chris7topher/SmartPhilips2200/(threads)

Thread 1 (2020-10-22):

Kabel Schneiden

M4D1NG3R, 2020-10-22:
Also erstmal echt cools Projekt,

ich habe mir gestern auch eine Philips EP2220/10 bestellt. Ich Wechsel von einer Smarter Coffee nun zu einem Vollautomaten, da mir der Kaffee auf der Smarter einfach nicht richtig schmeckt. Leider dauert es noch ein paar Tage bis diese geliefert wird.

Du hast in deinem 1. Video gesagt, dass du Kontakte an die Kabel gelötet hast. Ist das Kabel fest am Display verbaut oder sind dort Kontakte, sodass man evtl. durch Adapter o.Ä. auch ohne die original Kabel zu beschädigen die zusätzlichen Kabel anklemmen kann?

Und könntest du evtl. mal ein Bild in einer etwas besseren Auflösung als in deinem Video von der Schnittstelle am Display machen, das  würde mir zusätzlich wirklich helfen.

Schonmal Danke für deine Antwort!

LG

chris7topher, 2020-10-23:
Hallo,

das Kabel ist am Display angesteckt. Leider habe ich erst zu spät erfahren, dass es sich um einen Picoflex Stecker von Molex handelt. Schau am besten mal ins iobroker Forum, da habe ich mal ein paar Bilder eingestellt, wie ich das mittels Steckverbindungen gelöst habe:
[https://forum.iobroker.net/topic/30870/philips-kaffeevollautomat-ep2220-10-mittels-iobroker-steuern/21](forum.iobroker)

Am coolsten wäre es natürlich das einfach mit einem Picoflex Stecker als Zwischenmodul zu bauen.

M4D1NG3R, 2020-10-23:
Vielen Dank für die schnelle Antwort. Wieviele Pole hat denn das Picoflex Kabel?
Dann würde ich mir gleich eine Verlängerung bestellen :)

chris7topher, 2020-10-23:
Das ist ein 8 poliger Stecker. Das hier müsste der Typ vom Kabel zur Maschine hin sein: 90327-0308
Dazu bräuchtest du halt noch das männliche Gegenstück, das gibt es aber meines Wissens nach nur für Platinen zum auflöten. Beispielsweise das hier müsste laut Datenblatt passen: 90325-7008

Closed 2020-11-08.

Thread 2 (2021-09-29):

Verkabelung vereinfachen

student-maker, 2021-09-29:
Das Projekt ist klasse, aber die Verkabelung könnte denke ich noch etwas vereinfacht werden.
In https://github.com/chris7topher/SmartPhilips2200/issues/1#issuecomment-715045243 wurden ja bereits die Kabel und Stecker/Buchsen genannt.

Meinst du, es bestünde Interesse an einer Platine, auf der ein ESP8266 samt Spannungsregler und den korrekten Buchsen sitzt?

janniklas1998, 2022-01-07:
> Das Projekt ist klasse, aber die Verkabelung könnte denke ich noch etwas vereinfacht werden. In [#1 (comment)](https://github.com/chris7topher/SmartPhilips2200/issues/1#issuecomment-715045243) wurden ja bereits die Kabel und Stecker/Buchsen genannt.
>
> Meinst du, es bestünde Interesse an einer Platine, auf der ein ESP8266 samt Spannungsregler und den korrekten Buchsen sitzt?

Moin, wäre es möglich dass du dich per janniklas@muell.monster mal mit mir in Verbindung setzt? Hätte Interesse an so einer Platine

calipposcout, 2022-08-11:
Ich hätte tatsächlich Interesse daran. Die Kabel sind beim 2231/40 (LatteGo) wahrscheinlich gleich?

walthowd, 2022-08-11:
Ich wäre auch interessiert, habe aber die 3200-Serie und plane, diese in Zukunft zu erkunden.

Bobacatt, 2022-12-22:
Can someone pls sende an pinout for the D1? Mine isnt working Like it should.

Thread 3 (2021-11-21):

Confirming your connector had 5v power on both ends

poldim, 2021-11-21:
I found when doing some checking on my similar 3200 machine it has 5v on both pins 1 & 2 and 8 & 7.  Do you remember if this was the same for you?

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

veonua, 2022-09-08:
true

Thread 4 (2022-09-05):

Initialization is not complete

veonua, 2022-09-05:
When I send the power on command, it seems the chip doesn't send all the initialization commands needed.

The Hot Water test on my LatteGo 3200 ended up with a tray full of cold water. It doesn't even go through the regular pipe but dumps directly into the tray.

The coffee test ended up with cold coffee.

micki88, 2022-11-11:
I have the same machine (LatteGo 3200) and expiriencingsome strange behavior.
I have managed to map all the commands from the display (they are different to the 2200 model). But when I connect the esp to the machine and say press espresso, after some seconds it starts on its own and then just stops the process.
Maybe errors in the forward of the serail.read to serial.write?
I am new to arduino...

veonua, 2022-11-11:
@micki88 most likely you mapped commands wrong. do you have your code anywhere on GitHub

micki88, 2022-11-11:
@veonua Hi https://github.com/micki88/Philips-ep3200-testing This is just Christophers code that I modified fo ep 3200.

veonua, 2022-11-11:
my start commands are

  byte cmd1[] = {0xd5, 0x55, 0x0a, 0x01, 0x03, 0x00, 0x0d, 0x00, 0x00, 0x00, 0x1d, 0x36};
  byte cmd2[] = {0xd5, 0x55, 0x01, 0x01, 0x03, 0x00, 0x0d, 0x00, 0x00, 0x00, 0x36, 0x03};

I needed both to init successfully

micki88, 2022-11-11:
Thx. My problem the start/stopbutton/command. It is beeing randomly activated. So when I press something like coffee and wait, it just starts on his own. Or if I start making coffee the machine randomly stops if it has been stoped on the button. And I hear the beep sound, as you would press the start/stop button.
I dont understand how It is beeing activated on its own...

veonua, 2022-11-11:
probably you need to check your wires, the start/stop button command is just one bit. it might be a noise

micki88, 2022-11-13:
Thx veonua. I checked all wires again.  Still have same issue. Could the noise be coming from the unused softserial TX pin?

micki88, 2022-11-14:
[Solved]
Just to inform, I have solved the issue  by swapping the serial and software serial communication. It now works. Thx again for help.

sendorm, 2022-11-30:
Hello @micki88 so your codes works for ep3200 series right? Do all the settings work? The coffee types etc? Thanks

veonua, 2022-11-30:
it's just an emulation of a button press by button number.
I got a hidden “americano” discovered on my 2200 just by using the last known index +1 code

micki88, 2022-11-30:
Yup all works. Would be cool to find out the code for "steam" on the latteGo machines like mine. So we could make hot milk without the need to stop the capuccino or latteMachiato program

sendorm, 2022-11-30:
Do you have pictures of your setup and can you provide items list? People seem to be having issues with what to use. Which pin to connect etc? Maybe asking too much here :) Most of my experience is with esphome devices. Asked at their discord too if this can be implemented or not. Having this features on homeassistant will be great.

walthowd, 2022-11-30:
I'm a 3200 machine user as well, and would be happy to collaborate somewhere

veonua, 2022-12-01:
@walthowd just create a fork or a new project

flashmandv, 2024-01-01:
Guys, does anyone know what could be the reason for the display not working when powered on from the ESP?
My Phillips is EP3246. Commands work fine but I can't power on the display. If I power on the machine from its display button, then the display is updated OK when I send any commands from the ESP.

I checked the transistor and it works fine. It cuts the ground to the display for 300ms (tried different values). I also tried to cut the display GND manually or before/after sending the power on command. Nothing works. Please help me power on the display from the ESP.
Thanks

micki88, 2024-01-01:
@flashmandv probably wrong command or you maybe need two commands. Try command from my fork for 3200 series.

flashmandv, 2024-01-01:
@micki88 the commands from your repo should be fine as the machine turns on just fine. It is just the display that refuses to turn on :/ Maybe for my machine the cutout to ground for 300ms is not working..but it is strange as this works for the other machines from 3200 series.

micki88, 2024-01-01:
@flashmandv Ok, just to be sure, you did cut the other cables? I think I remember having two cables to ground on the display...

micki88, 2024-01-01:
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

Can you try this power on commands

flashmandv, 2024-01-01:
> @flashmandv Ok, just to be sure, you did cut the other cables? I think I remember having two cables to ground on the display...

Actually I haven't cut all the wires to the display. I only cut the Tx and the GND (that is next to the 5V).
Do I need to cut the other unused cables? The 3th cable (that is again GND) needs to be cut completely? or wired to the transistor so he cuts it momentarily?

Thanks for the new commands. I will try them today

flashmandv, 2024-01-01:
Thank you @micki88 It worked when I cut the 3th ground pin and connected it to the transistor emitter.
Now it remained to clear some strange bugs (setting water level and strength level does not work properly..maybe because the machine update statis is not always updating)

Thread 5 (2022-11-10):

AP remains open

xjustbmw, 2022-11-10:
Hi there,

Very nice project.
Did you manage to repair your machine ? what is/was wrong with it ?

I got the cable connectors and compiled/installed the webserver version on a d1 mini.

Can we disable the esp-coffee-machine AP if connection is successfull to the router ?

micki88, 2022-11-11:
Hi. Do you have the same machine or is it another model. I have LatteGo 3200. Could use some help..

xjustbmw, 2022-11-11:
hi miki, i got the 2200 as well. 3200 should need more commands captured I assume ?

micki88, 2022-11-11:
Hi. I have captured the other commands, but the machine starts/stops randomly on its own. Its odd, I hear the beep sound and see that the start/stop button has been activated

xjustbmw, 2022-11-12:
Only the display randomly starts ?

xjustbmw, 2022-11-14:
I have also a quick question regarding the diagram.
Which part of the cable is actually shown in the picture ? the one connecting to the mainboard or the display ?

micki88, 2022-11-14:
Its the display side of the cable

xjustbmw, 2022-11-14:
alright :) I put everything on a strip board, now waiting for an extender cable.
many thanks for this info, did you manage to solve your issues? the random starts are on the display side or the machine restarts completely ?

micki88, 2022-11-14:
I did resolve it. Swaped the serial and sofware serial port and have no issues anymore :)

xjustbmw, 2022-11-14:
hm, which controller do you use ? I got a d1 mini , since there is no need for any voltage regulator, and it can be easily programmed via usb

xjustbmw, 2022-11-14:
Btw. On the mainboard the picoflex connector is also SMD type ?
I read on a post that somebody managed to rip off display connector when trying to unplug the cable from it.

micki88, 2022-11-14:
MB dont know, but display side I used small screwdriver and unplagged the cable easily. Its been secured whit two plastic notches on sides. I used a nodemcu board

xjustbmw, 2022-11-14:
Alright, This really seems quite a delicate connector. With care I think it will come off in one piece.
I think the default RX TX on d5 d6 are shared with the usb programmer on this D1 mini.
I could see the commands send to the mainboard on serial monitor, but no debugging information.
That was the issue for you as well ?

micki88, 2022-11-14:
Not sure could be I just changed the code to write the commands to software serial pin and read from hardware serial pin  and it works now

xjustbmw, 2022-11-14:
I just plugged it in as well and made the first coffee using manual mqtt commands :)

The mainboard doesnt really have the same connector, I used the display socket as well.
Works very nice without any modification on the software side.

walthowd, 2022-11-14:
@micki88 -- I have a 3200 as well - -Do you have the changes you made and/or the schematic posted somewhere?

xjustbmw, 2022-11-14:
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

micki88, 2022-11-18:
> @micki88 -- I have a 3200 as well - -Do you have the changes you made and/or the schematic posted somewhere?

Hi, Here are my command for EP3200. Yours might be different.
https://github.com/micki88/Philips-ep3200-testing.git

xjustbmw, 2022-11-18:
Few ideas on this code:
Just curious. What is the ping reply of your module when the machine is off ?

I discovered that ArduinoOTA.handle(); causes it to somehow randomly timeout when the coffee machine is off. I guess the loop through this handle is too high and overloads the esp.
Removing the ota part resumed the reply to: 1-10ms.

Also, I changed the mqtt reconnection attempt every 30 seconds (without using any delay() code and only if wifi is connected), in case the network or mqtt server is off, the buttons of the coffe machine are still functional.

micki88, 2022-11-18:
I do kinda understand the code but i'm not good in coding. What I did see is the timeout and button hanging on the display. Would be greate if you could share your modifications.

xjustbmw, 2022-11-18:
sure thing.But I only modified withoutserver version.

First I tested the webserver version and got random timeouts.
Went back to the withoutwebserver and got it working but the display randomly hang when mqtt/wifi was off.

Discovered this issue by mistake when I got the exact same problem back when I tried to add the ArduinoOTA in the version without webserver :)

Perhaps this is just caused by my old arduinoide , which I needed for some other project.

micki88, 2022-11-18:
That would be awesome. withoutserver version is fine. :). I use too an older version of Arduino IDE. Could be the same thing...

Jonny-T-cyber, 2022-11-19:
> 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

Hi!
May I ask where did you buy the flat cables with the two connectors?
Can I order them online?
Thank a lot

xjustbmw, 2022-11-19:
I got them on tme.eu But they are available anywhere I think.
Picoflex codes: MX-90325-0008 (2 pieces) and MX-92315-0825 (1 piece)
In this way you can put two connectors on your mainboard and use the extnder cable to connect from the board to the display.

Jonny-T-cyber, 2022-11-20:
> I got them on tme.eu But they are available anywhere I think. Picoflex codes: MX-90325-0008 (2 pieces) and MX-92315-0825 (1 piece) In this way you can put two connectors on your mainboard and use the extnder cable to connect from the board to the display.

Ok, ttanks.
The problem is that I have already cut the original cable.
I would definitely buy the MX-92315-0825 cable.
Now the question is:
if I buy a female connector will I be able to crimp it on the original cable easily or is the crimping tool necessary?
Tnaks

xjustbmw, 2022-11-20:
If you already cut your cable I would put different 4 pin connectors on both ends.
I managed to also crimp one cable using a usb stick and then a small screwdriver, each pin at a time :) In the end decided to replace with an already crimped cable extension and not cut the original cable, since my unit is in warranty.

Jonny-T-cyber, 2022-11-20:
> If you already cut your cable I would put different 4 pin connectors on both ends. I managed to also crimp one cable using a usb stick and then a small screwdriver, each pin at a time :) In the end decided to replace with an already crimped cable extension and not cut the original cable, since my unit is in warranty.

I'm thinking about the 4 pin connectors...
But one more thing:i
f I look at the back of the male connector, I don't understand how you soldered it on the breadboard because the distance between the points to be soldered seems different from that between the holes on the breadboard

xjustbmw, 2022-11-20:
I bent each 4 pins in opposite directions :)

eric1905, 2022-11-23:
> 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

This looks very good. i will try to order the cable and the connector as well.
Do you have a photo from the back of this breadboard?

Do you have a transistor as well? With a resistor? Or is there now a better solution?

xjustbmw, 2022-11-24:
Yes. I have everything like the schematic on the board.
Unfortunately I didnt make photos behind the board.
D5 D6 D7 are off by 1 position.

eric1905, 2022-11-24:
@xjustbmw

I am not that familar with transistors and resistors.
I read in the IOBroker forum that this transistor should be ok.
https://forum.iobroker.net/topic/30870/philips-kaffeevollautomat-ep2220-10-mittels-iobroker-steuern/38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
Is there a specific watt value needed for the resistor? Why 330 Ohm?

Do you think those are are suitable?
https://www.tme.eu/de/en/details/cf1_4w-330r/1-4w-carbon-tht-resistors/sr-passives/
https://www.tme.eu/de/en/details/bc547c/npn-tht-transistors/semtech-ltd/bc547c-bulk/

Bobacatt, 2022-12-23:
Did somebody has the pinout for the d1? Mine isnt working like it should.

walthowd, 2023-01-16:
Built mine with a NodeMCU I had laying around:

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

Used these parts:
- [Molex 90325-0008 Connector](https://www.mouser.com/ProductDetail/Molex/90325-0008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)
- [Molex 92315-0825 Cable](https://www.mouser.com/ProductDetail/Molex/92315-0825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)
- [BC33725TFR NPN Transistor](https://www.mouser.com/ProductDetail/onsemi-Fairchild/BC33725TFR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)

Didn't need to convert voltage as the NodeMCU has an onboard voltage regulator.

I have a 3200 so used this fork - https://github.com/micki88/Philips-ep3200-testing.git

The AP does not stay open for me but I did update the main `loop()` function to not hammer MQTT server if down - props @xjustbmw

```
void loop() {
  static unsigned long lastMQTTConnection = 0;
  if (WiFi.status() == WL_CONNECTED) {
    //The following things can only be handled if wifi is connected
    ArduinoOTA.handle();

    if (!mqttClient.connected() && millis() - lastMQTTConnection >= 30000) {
      lastMQTTConnection = millis();
      mqttConnect();
    }
    mqttClient.loop();
    serialInput2Mqtt();
  }

  while (swSer.available() > 0) {
    Serial.write(swSer.read());
  }

  portal.handleClient();
}
```

Now just need to figure out the Home Assistant side of things. 😓

Also noticed that my custom dispense liquid amount for coffee is reset -- Previously, I had manually calibrated that to the machine to have two coffees perfectly fill my large mug. Now that seems to have reverted back to the default which takes the coffee to the very top of the mug. :)

walthowd, 2023-01-16:
Tracking fork here - https://github.com/walthowd/Philips-ep3200-ha

walthowd, 2023-01-17:
Just received the indicator light that the grounds (Trester / pomace) needs to be emptied and with the ESP8266 hooked up, I could not clear that state. Opening the grounds bin, or any other action would not reset the system and allow it to brew coffee again.

Out of curiosity. has anyone else seen this? I only hooked up the four wires as shown in the wiring diagram. Perhaps the other wires are still needed?

xjustbmw, 2023-01-17:
There is a pin that moves when you insert the grounds tray. Your esp is preventing that pin from moving, hence it is not detecting that you emptied the tray.
I had the same thing happen.
Move the esp module to the left behind the display :)

xjustbmw, 2023-01-17:
Also consider that there is alot of steam going around that area.
Better to seal the esp module to avoid future damage on it.

walthowd, 2023-01-17:
Hah! Thanks @xjustbmw , that did it --  I was just getting out the multimeter and soldering iron! 😂

xjustbmw, 2023-01-17:
Perfect. I had to open the machine, removed the contact from the motherboard from that pin, only to then discover what was causing it (using a multimeter as well) :)

Jonny-T-cyber, 2023-01-24:
Hi all!
Does anyone know if it is possible to port this project to a 4300 series machine?

eric1905, 2023-06-13:
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

Did you manage to do the home assistant side? Maybe you could share your configuration

walthowd, 2023-06-14:
Haven't had time to come back to this yet -- currently just using `coffee/command/powerOn` MQTT to bring it to life when I want

eric1905, 2023-06-15:
> Tracking fork here - https://github.com/walthowd/Philips-ep3200-ha

When I check your description: your sentence:
PIN2 - Ground
Connect to Ground / GND on ESP8266 and connect to [collector leg of NPN transistor](https://www.mouser.com/datasheet/2/308/1/BC338_D-1802398.pdf)

is not the same as your picture. When I check the mouse description, the collector leg is the first one. In the picture it is wired to the emitter leg

Thread 6 (2023-02-03):

Wemos D1 Mini

Gogmaghog, 2023-02-03:
I've got a little problem with Wemos D1

The machine can no longer be operated via the display.
If it is off, I can switch it on via the display, but nothing else. I can actually control everything via objects in the Iobroker, but if I switch them off, the machine beeps 3x at irregular intervals and the machine switches back on immediately.

Status indicators such as the water tank are not shown on the display.

Has anyone managed to get it to work with this board?

walthowd, 2023-02-03:
You must have it wired up incorrectly for the TX/RX from the D1 to the display -- See https://github.com/walthowd/Philips-ep3200-ha#wiring-explaination

Thread 7 (2023-04-06):

Migrate to ESP32 with Ethernet.

nighteagle1974, 2023-04-06:
Hello, so have the idea to use ethernet instead of Wifi - because i don't want all of my home automation over wireless like Bluetooth or Zigbee or WLAN/Wifi. I use cable CAt5/6 and only on few spaces i use zigbee.
So for build my smart coffeemachine i want to use this cool project but i want to migrate to an esp32 with Ethernet on Board. Then i want to use in my iobroker the MQTT server to communicate with the ESP32 module or the similar project with esphome another guy here is migrated from this project here. Then have VIS on my Panels and can make Coffee from this VIS or even automatic starting in the Morning etc.

What a re the best way to begin? I thought this wt32-eth01 is enough - so need a voltage regulator and that it's or forget something?

Thread 8 (2023-05-07):

Coffee machine Philips 5400 Series LatteGo

DivanX10, 2023-05-07:
[I read this articl](https://hackcorrelation.blogspot.com/2021/05/philips-3200-coffee-machine-part-1.html)
[Watched this video](https://youtu.be/jhzEMkL5Xek)
[I looked at the ESPHome-Philips-Smart-Coffee project](https://github.com/TillFleisch/ESPHome-Philips-Smart-Coffee)

***

And I decided to repeat your experience and faced the problem of decrypting the data received in ESPHome

- How did you decrypt the protocol? How did you get these bytes?
```
esp 1x d5 55 00 07 00 00 00 00 00 07
esp 2x d5 55 00 38 00 00 00 00 00 07
lungo 1x d5 55 00 00 00 07 00 00 00 07
lungo 2x d5 55 00 00 00 38 00 00 00 07
coffee 1x d5 55 00 00 00 00 38 00 00 07
coffee 2x d5 55 00 00 00 00 00 07 00 07
amer 1x d5 55 00 00 07 00 00 00 38 07
amer 2x d5 55 00 00 38 00 00 00 38 07
hot water d5 55 00 00 00 00 07 00 00 00
steam d5 55 00 00 00 00 00 38 00 00
```
- Could you help decipher the protocol for the 5000 series coffee machine?

***

How did I find out that the 1000/2000/3000/5000 coffee machines use the motherboard number 1.9.30.330.00._v10, and the control panel is different for everyone

<details>
  <summary><b>Motherboards of coffee machines of the series 1000/2000/3000/5000</b></summary>

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

</details>

So, I measured the coffee machine with an oscilloscope and a multimeter and that's what turned out. Since the 8-core wire has two colors, black and gray, I had to make a color scheme for convenience. I drew an up-to-date diagram for the 5400 series coffee machine. Since the 8-core wire has two colors black and gray, and the black color is +5v, then for convenience I made colored lines and numbered the wiring

<details>
  <summary><b>Wiring diagram for the 5400 series coffee machine</b></summary>

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

</details>

<details>
  <summary><b>Measurements with an oscilloscope</b></summary>

According to the calculation, the speed is 116279 bits / s

I used the calculation formula F = 1/T
1) 8,6/1.000.000 = 0,0000086
2) 1/0,0000086=116 279,0697674419 = 116279 bits / s

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

</details>

Now it remains to understand how to properly capture data from the coffee machine. Now I use this option for debugging

***

Initially, I used this [scheme](https://github.com/TillFleisch/ESPHome-Philips-Smart-Coffee#wiring), but the control of the coffee machine does not work, although the switch turned on/off all the time, and the screen on the control panel turned off all the time. I used a BS170 transistor.

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

I decided that since the coffee machine turns off all the time and there is no control, I will connect the ESP8266 Wemos Mini just to read the data to try to find the right code

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

***

### Logs from ESPHome
<details>
  <summary><b>If I don't specify 12 bytes</b></summary>

```
uart:
#UART connected to the display
   rx_pin: GPIO3
   baud_rate: 115200
   stop_bits: 1
   data_bits: 8
   parity: none
   debug:
    dummy_receiver: true
```

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

```
19:14:47	[D]	[uart_debug:114]
<<< 12:FA:EE:41:0A:55:AA:AA:AA:FF:13:01:13:5B:B4:84:7C:55:AA:AA:AA:FF:14:01:14:7D:37:AF:E7:55:AA:AA:AA:FF:15:01:15:DC:6D:6A:91:55:AA:AA:AA:FF:16:01:16:3F:82:25:0A:55:AA:AA:AA:FF:16:01:16:3F:82:25:0A:55:AA:AA:AA:FF:17:01:17:9E:D8:E0:7C:55:AA:AA:AA:FF:18:01:18:32:82:03:E7:55:AA:AA:AA:FF:18:01:18:32:82:03:E7:55:AA:AA:AA:FF:19:01:19:93:D8:C6:91:55:AA:AA:AA:FF:19:01:19:93:D8:C6:91:55:AA:AA:AA:FF:1A:01:1A:70:37:89:0A:55:AA:AA:AA:FF:1B:01:1B:D1:6D:4C:7C:55
19:14:47	[D]	[uart_debug:114]
<<< AA:AA:AA:FF:1C:01:1C:F7:EE:67:E7:55:AA:AA:AA:FF:1D:01:1D:56:B4:A2:91:55:AA:AA:AA:FF:1E:01:1E:B5:5B:ED:0A:55:AA:AA:AA:FF:1F:01:1F:14:01:28:7C:55:AA:AA:AA:FF:20:01:20:84:8E:79:E5:55:AA:AA:AA:FF:21:01:21:25:D4:BC:93:55:AA:AA:AA:FF:22:01:22:C6:3B:F3:08:55:AA:AA:AA:FF:23:01:23:67:61:36:7E:55:AA:AA:AA:FF:24:01:24:41:E2:1D:E5:55:AA:AA:AA:FF:25:01:25:E0:B8:D8:93:55:AA:AA:AA:FF:26:01:26:03:57:97:08:55:AA:AA:AA:FF:27:01:27:A2:0D:52:7E:55:AA:AA:AA:FF:28:01
19:14:47	[D]	[uart_debug:114]
<<< 28:0E:57:B1:E5:55:AA:AA:AA:FF:29:01:29:AF:0D:74:93:55:AA:AA:AA:FF:2A:01:2A:4C:E2:3B:08:55:AA:AA:AA:FF:2B:01:2B:ED:B8:FE:7E:55:AA:AA:AA:FF:2C:01:2C:CB:3B:D5:E5:55:AA:AA:AA:FF:2D:01:2D:6A:61:10:93:55:AA:AA:AA:FF:2E:01:2E:89:8E:5F:08:55:AA:AA:AA:FF:2F:01:2F:28:D4:9A:7E:55:AA:AA:AA:FF:30:01:30:90:3D:E8:E4:55:AA:AA:AA:FF:31:01:31:31:67:2D:92:55:AA:AA:AA:FF:32:01:32:D2:88:62:09:55:AA:AA:AA:FF:33:01:33:73:D2:A7:7F:55:AA:AA:AA:FF:34:01:34:55:51:8C:E4:55
19:14:48	[D]	[uart_debug:114]
<<< AA:AA:AA:FF:35:01:35:F4:0B:49:92:55:AA:AA:AA:FF:36:01:36:17:E4:06:09:55:AA:AA:AA:FF:37:01:37:B6:BE:C3:7F:55:AA:AA:AA:FF:38:01:38:1A:E4:20:E4:55:AA:AA:AA:FF:39:01:39:BB:BE:E5:92:55:AA:AA:AA:FF:3A:01:3A:58:51:AA:09:55:AA:AA:AA:FF:3B:01:3B:F9:0B:6F:7F:55:AA:AA:AA:FF:3C:01:3C:DF:88:44:E4:55:AA:AA:AA:FF:3D:01:3D:7E:D2:81:92:55:AA:AA:AA:FF:3E:01:3E:9D:3D:CE:09:55:AA:AA:AA:FF:3F:01:3F:3C:67:0B:7F:55:AA:AA:AA:FF:40:01:40:FC:24:1C:E0:55:AA:AA:AA:FF:41:01
19:14:48	[D]	[uart_debug:114]
<<< 41:5D:7E:D9:96:55:AA:AA:AA:FF:42:01:42:BE:91:96:0D:55:AA:AA:AA:FF:43:01:43:1F:CB:53:7B:55:AA:AA:AA:FF:44:01:44:39:48:78:E0:55:AA:AA:AA:FF:45:01:45:98:12:BD:96:55:AA:AA:AA:FF:46:01:46:7B:FD:F2:0D:55:AA:AA:AA:FF:47:01:47:DA:A7:37:7B:55:AA:AA:AA:FF:48:01:48:76:FD:D4:E0:55:AA:AA:AA:FF:49:01:49:D7:A7:11:96:55:AA:AA:AA:FF:4A:01:4A:34:48:5E:0D:55:AA:AA:AA:FF:4B:01:4B:95:12:9B:7B:55:AA:AA:AA:FF:4C:01:4C:B3:91:B0:E0:55:AA:AA:AA:FF:4D:01:4D:12:CB:75:96:55
19:14:48	[D]	[uart_debug:114]
<<< AA:AA:AA:FF:4E:01:4E:F1:24:3A:0D:55:AA:AA:AA:FF:4F:01:4F:50:7E:FF:7B:55:AA:AA:AA:FF:50:01:50:E8:97:8D:E1:55:AA:AA:AA:FF:51:01:51:49:CD:48:97:55:AA:AA:AA:FF:52:01:52:AA:22:07:0C:55:AA:AA:AA:FF:53:01:53:0B:78:C2:7A:55:AA:AA:AA:FF:54:01:54:2D:FB:E9:E1:55:AA:AA:AA:FF:55:01:55:8C:A1:2C:97:55:AA:AA:AA:FF:56:01:56:6F:4E:63:0C:55:AA:AA:AA:FF:57:01:57:CE:14:A6:7A:55:AA:AA:AA:FF:58:01:58:62:4E:45:E1:55:AA:AA:AA:FF:59:01:59:C3:14:80:97:55:AA:AA:AA:FF:5A:01
19:14:48	[D]	[uart_debug:114]
<<< 5A:20:FB:CF:0C:55:AA:AA:AA:FF:5B:01:5B:81:A1:0A:7A:55:AA:AA:AA:FF:5C:01:5C:A7:22:21:E1:55:AA:AA:AA:FF:5D:01:5D:06:78:E4:97:55:AA:AA:AA:FF:5E:01:5E:E5:97:AB:0C:55:AA:AA:AA:FF:5F:01:5F:44:CD:6E:7A:55:AA:AA:AA:FF:60:01:60:D4:42:3F:E3:55:AA:AA:AA:FF:61:01:61:75:18:FA:95:55:AA:AA:AA:FF:62:01:62:96:F7:B5:0E:55:AA:AA:AA:FF:63:01:63:37:AD:70:78:55:AA:AA:AA:FF:64:01:64:11:2E:5B:E3:55:AA:AA:AA:FF:65:01:65:B0:74:9E:95:55:AA:AA:AA:FF:66:01:66:53:9B:D1:0E:55
19:14:49	[D]	[uart_debug:114]
<<< AA:AA:AA:FF:67:01:67:F2:C1:14:78:55:AA:AA:AA:FF:68:01:68:5E:9B:F7:E3:55:AA:AA:AA:FF:69:01:69:FF:C1:32:95:55:AA:AA:AA:FF:6A:01:6A:1C:2E:7D:0E:55:AA:AA:AA:FF:6B:01:6B:BD:74:B8:78:55:AA:AA:AA:FF:6C:01:6C:9B:F7:93:E3:55:AA:AA:AA:FF:6D:01:6D:3A:AD:56:95:55:AA:AA:AA:FF:6E:01:6E:D9:42:19:0E:55:AA:AA:AA:FF:6F:01:6F:78:18:DC:78:55:AA:AA:AA:FF:70:01:70:C0:F1:AE:E2:55:AA:AA:AA:FF:71:01:71:61:AB:6B:94:55:AA:AA:AA:FF:72:01:72:82:44:24:0F:55:AA:AA:AA:FF:73:01
19:14:49	[D]	[uart_debug:114]
<<< 73:23:1E:E1:79:55:AA:AA:AA:FF:74:01:74:05:9D:CA:E2:55:AA:AA:AA:FF:75:01:75:A4:C7:0F:94:55:AA:AA:AA:FF:76:01:76:47:28:40:0F:55:AA:AA:AA:FF:77:01:77:E6:72:85:79:55:AA:AA:AA:FF:78:01:78:4A:28:66:E2:55:AA:AA:AA:FF:79:01:79:EB:72:A3:94:55:AA:AA:AA:FF:7A:01:7A:08:9D:EC:0F:55:AA:AA:AA:FF:7B:01:7B:A9:C7:29:79:55:AA:AA:AA:FF:7C:01:7C:8F:44:02:E2:55:AA:AA:AA:FF:7D:01:7D:2E:1E:C7:94:55:AA:AA:AA:FF:7E:01:7E:CD:F1:88:0F:55:AA:AA:AA:FF:7F:01:7F:6C:AB:4D:79:55
19:14:49	[D]	[uart_debug:114]
<<< AA:AA:AA:FF:80:01:80:0C:70:D7:EA:55:AA:AA:AA:FF:81:01:81:AD:2A:12:9C:55:AA:AA:AA:FF:82:01:82:4E:C5:5D:07:55:AA:AA:AA:FF:83:01:83:EF:9F:98:71:55:AA:AA:AA:FF:84:01:84:C9:1C:B3:EA:55:AA:AA:AA:FF:85:01:85:68:46:76:9C:55:AA:AA:AA:FF:86:01:86:8B:A9:39:07:55:AA:AA:AA:FF:87:01:87:2A:F3:FC:71:55:AA:AA:AA:FF:88:01:88:86:A9:1F:EA:55:AA:AA:AA:FF:89:01:89:27:F3:DA:9C:55:AA:AA:AA:FF:8A:01:8A:C4:1C:95:07:55:AA:AA:AA:FF:8B:01:8B:65:46:50:71:55:AA:AA:AA:FF:8C:01
19:14:49	[D]	[uart_debug:114]
```
</details>

<details>
  <summary><b>If I specify 12 bytes</b></summary>

```
uart:
  rx_pin: GPIO3
  baud_rate: 115200
  stop_bits: 1
  data_bits: 8
  parity: none
  debug:
    dummy_receiver: true
    after:
      bytes: 12
```
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

</details>

DivanX10, 2023-05-18:
I opened a topic [here](https://community.home-assistant.io/t/esp-smart-offee-machine-philips-5400-series/568545/24), and this one will be closed.

Closed 2023-05-18.

Thread 9 (2023-05-18):

Command Bytes for ep2231 lattego

Endorian88, 2023-05-18:
hi, first of all thanks for this great project.

I have the following problem. The 2231 has the cappuccino button at the point where you have the steam button. However, when I try to make a cappuccino, the machine wants to make steam instead of Cappuccino. Looks funny but no Cappuccino for me.
I also tried the bytes from the 3200, there is cappuccino then hot water and the latte only makes steam.

does anyone have the byte for cappuccino in the 2231? or maybe you have already upgraded your coffee machine?

Unfortunately I didn't know where else to ask.

micki88, 2023-05-19:
Hi you need to read out your commands from the serial signal when button pressed on display.

flashmandv, 2024-01-03:
@DivanX10 can you help me with some ideas why my Phillips 3200 series is randomly starting the brewing process, when brew is selected, but before start_cmd is sent?
I've read all info in github (4-5 repos). I also read your struggle with the 5400 series (**amazing job btw. Huge respect**!)

This is the code in the loop method that routes the machine Tx pin and it works, but random start cmds appear after I select (from ESP code or via machine button) the brew type (coffee, hot water..etc)
`while (swSer.available() > 0) {
      Serial.write(swSer.read());
    }`

I use same pins as Christopher code but these random start commands are ruining it all.

I commented almost all of the code to find the reason and there is nothing else to comment. This while that sends from SoftwareSerial to the Serial should be all fine..but no idea

Could it be my wiring schematics?
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

Cable1: 5v- goes to the ESP and to coffee machine
Cable2: GND - routed through the transistor as per Christopher wiring
Cable3: GND2 - routed through the transistor (disconnecting it or wiring it directly does not turn on the display when I power it on from the ESP)
Cable4: Connected to the display (as it was before I touched the coffee machine)
Cable5: Rx - Goes to both display and ESP as per Christopher wiring
Cable6: Tx - routed through the ESP as per Christopher wiring
Cable7: Goes to the display as it was before I touch anything
Cable8: Goes to the display as it was before I touch anything

I may try to cut the 7 and 7 cable pins but doubt that it would work

Thank you!
I hope for your reply as I'm getting crazy

micki88, 2024-01-03:
Are you usinig nodemcu? Probably noise... try switching hw and sw serial as pass thru with sw serial instead hw serial.

flashmandv, 2024-01-03:
Yes, NodeMCU v2. I tried using SoftwareSerial for both reading and receiving (not sure if this is what you mean?):

while (swSer.available() > 0)
   SoftwareSerialOut.write(swSer.read());

DivanX10, 2024-01-03:
@flashmandv

I don't have a Phillips 3200. The 3200 and 5400 are different machines, different protocols, different controls. Try an ESP32 board. What we mean by noise is that the contact can behave unpredictably and send signals, thereby triggering a command. Read [here](https://randomnerdtutorials.com/esp8266-pinout-reference-gpios/). I won’t tell you about the code - I don’t know.

The pins highlighted in green are OK to use. The ones highlighted in yellow are OK to use, but you need to pay attention because they may have unexpected behavior mainly at boot. The pins highlighted in red are not recommended to use as inputs or outputs.
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

flashmandv, 2024-01-03:
Thank you @DivanX10
I am using D5 (which is green OK) to read and writing to the Serial Tx (GPIO 1)..which is yellow for output as I now see.
I'll try tomorrow using other pin for the write but I'm pessimistic as @chris7topher is using it successfully.
I'll also get ESP32 board and see with it.
Btw could it be the devboard (NodeMCU)? @chris7topher is using the ESP8266 "naked"..so I don't know if the devboard can affect it.
Thanks

flashmandv, 2024-01-04:
Hello again guys,

Today I bought ESP32 NodeMCU V1 dev board and **IT WORKED!!**
No ghost start commands. I only tested the machine to display UART forwarding (but I hope everything else will work too).
The ESP8266 devboard may not have worked because of the new firmwares I was flashing (tried installint AT and updating everything). It may also be the Serial UART0 that the devboard USB may have used. I see ESP32 has 3 UARTS so it is best option.

Thanks a lot guys!

Thread 10 (2023-12-24):

Coffee machine display not working

flashmandv, 2023-12-24:
Hey Christopher,

Thank you for the awesome library. I'm trying to make my coffee machine smart (Phillips EP3246).
Using your code I'm able to get machine status successfully and I'm able to send commands, but the display refuses to work.
As I see the Tx pin is router through the ESP8266 but it seems my ESP is not able to route the communication to the display.
Not sure why..maybe I'm using the wrong pin?
I'm using NodeMCU dev board (so no voltage converter is needed).

I've seen in the code the pinouts are different depending on the board used. Not sure if that is the problem
`#if defined(ESP8266)
DisplayOutSerial.begin(115200);
#else
DisplayOutSerial.begin(115200, SERIAL_8N1, RX2_PIN, TX2_PIN);
#endif`

Here is my wiring and my Arduino ide project:
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

Could my code for setting LED pinout (used for testing) be a problem? `pinMode(2, OUTPUT);`
Or maybe incorrect board I've set in Arduino IDE?

Any help is welcome as I'm stuck.
Big thank you!

flashmandv, 2023-12-31:
It turned out that the display works fine if I power on the machine from its button. Then it works and it shows what I command sent.
But If I power on the machine from the  ESP, then the display does not turn on at all..no matter what commands I sent.
Any idea on what can it be? Did I messed up with the transistor?

Thanks

chris7topher, 2024-01-03:
Hi Flashmandv,

in my circuit, I have a transistor that I use to briefly cut off power to the display. This interruption in power is what triggers the display to start.

BR
Christopher

flashmandv, 2024-01-03:
Yes, thanks for the answer. I was using the transistor too..but it didn't work until I cut the second GND pin (pin 3 on the machine cable). Now most things are working but I get like ghost randomly starting/stopping start brewing commands (maybe noise..not sure). I just asked for help in this thread of your repo: [https://github.com/chris7topher/SmartPhilips2200/issues/9#issuecomment-1875897752](https://github.com/chris7topher/SmartPhilips2200/issues/9#issuecomment-1875897752)

I'll be very thankful if you give me some advice on that ghost auto start commands the machine is doing

flashmandv, 2024-01-05:
The autostart problem turned out to be a defective ESP8266 (probably)...or maybe bad connection (I did not used pullup resistors..mayne I should have tried).

I fixed it by replacing the ESP8266 with ESP32. Added some wifi web interface (server) and tried to add presets (but failed as the water/strangth level did not work due to the machine not updating its status in real time..despite trying with delays).
Nevermind, the custom coffee settings work great. I can turn on/off, start any type of coffee with setting it setting by setting and is all good.
Closing this for now. If anyone wants to contribute - here is my fork for Phillips 3246 [https://github.com/flashmandv/phillips-3246-smart](https://github.com/flashmandv/phillips-3246-smart)

Thread 12 (2025-09-06):

AutoConnect lib has XSS injection vulnerability through Wi-Fi beacon frame. (CVE-2025-50740) which impacts your project

AbhijithAJ, 2025-09-06:
Your device is vulnerable to [**CVE-2025-50740**](https://github.com/advisories/GHSA-w65f-mpfc-hjgq) and I suggest you fix this to ensure security of the project/device.

**Impact:**
A malicious user in vicinity could use this issue to

- Inject malicious code into the mobile from which the user is trying to configure the device.
- Make a connection to his own wi-fi network to keep the device in his control.
