chris7topher/SmartPhilips2200/(commit log)

2020-02-06 added iobroker stuff
    [coffeemachine.json]
2020-03-05 Webserver version added
    Added version with Webserver and added PowerOff recognition
2020-03-05 Power Event handler fixed
    fixed Power event handler
    [coffeemachine.json]
2020-05-11 Update withoutWebServer.ino
    Fixed powerOff MQTT message in version without webserver
    [withoutWebServer.ino]
